Hardware7253/GP1247AI_PSU/3D/PCB_Assembly.step

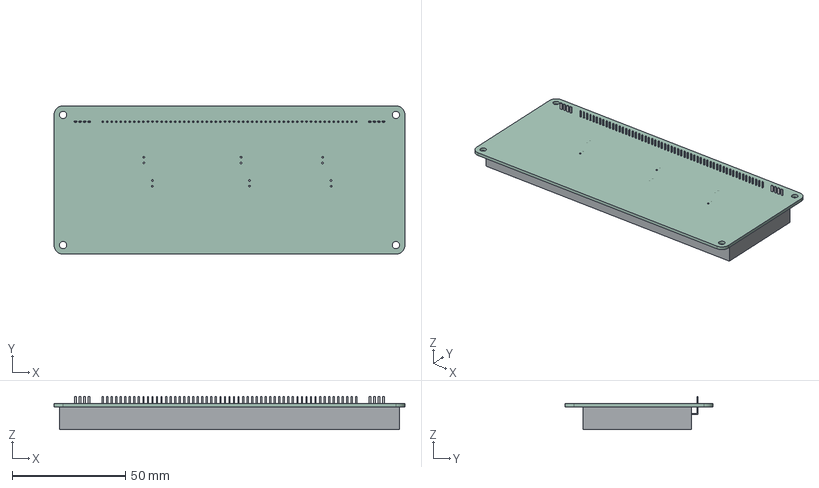
[picture p1: CAD file, 2026-01-06]
3D/PCB_Assembly.step
155.0 x 65.5 x 14.8 mm
Pin x 57
Filament Pin x 8
GP1247AI_PCB
