Hardware7253/GP1247AI_PSU/GP1247AI.kicad_sch

## KiCad design GP1247AI.kicad_sch (2026-01-14)

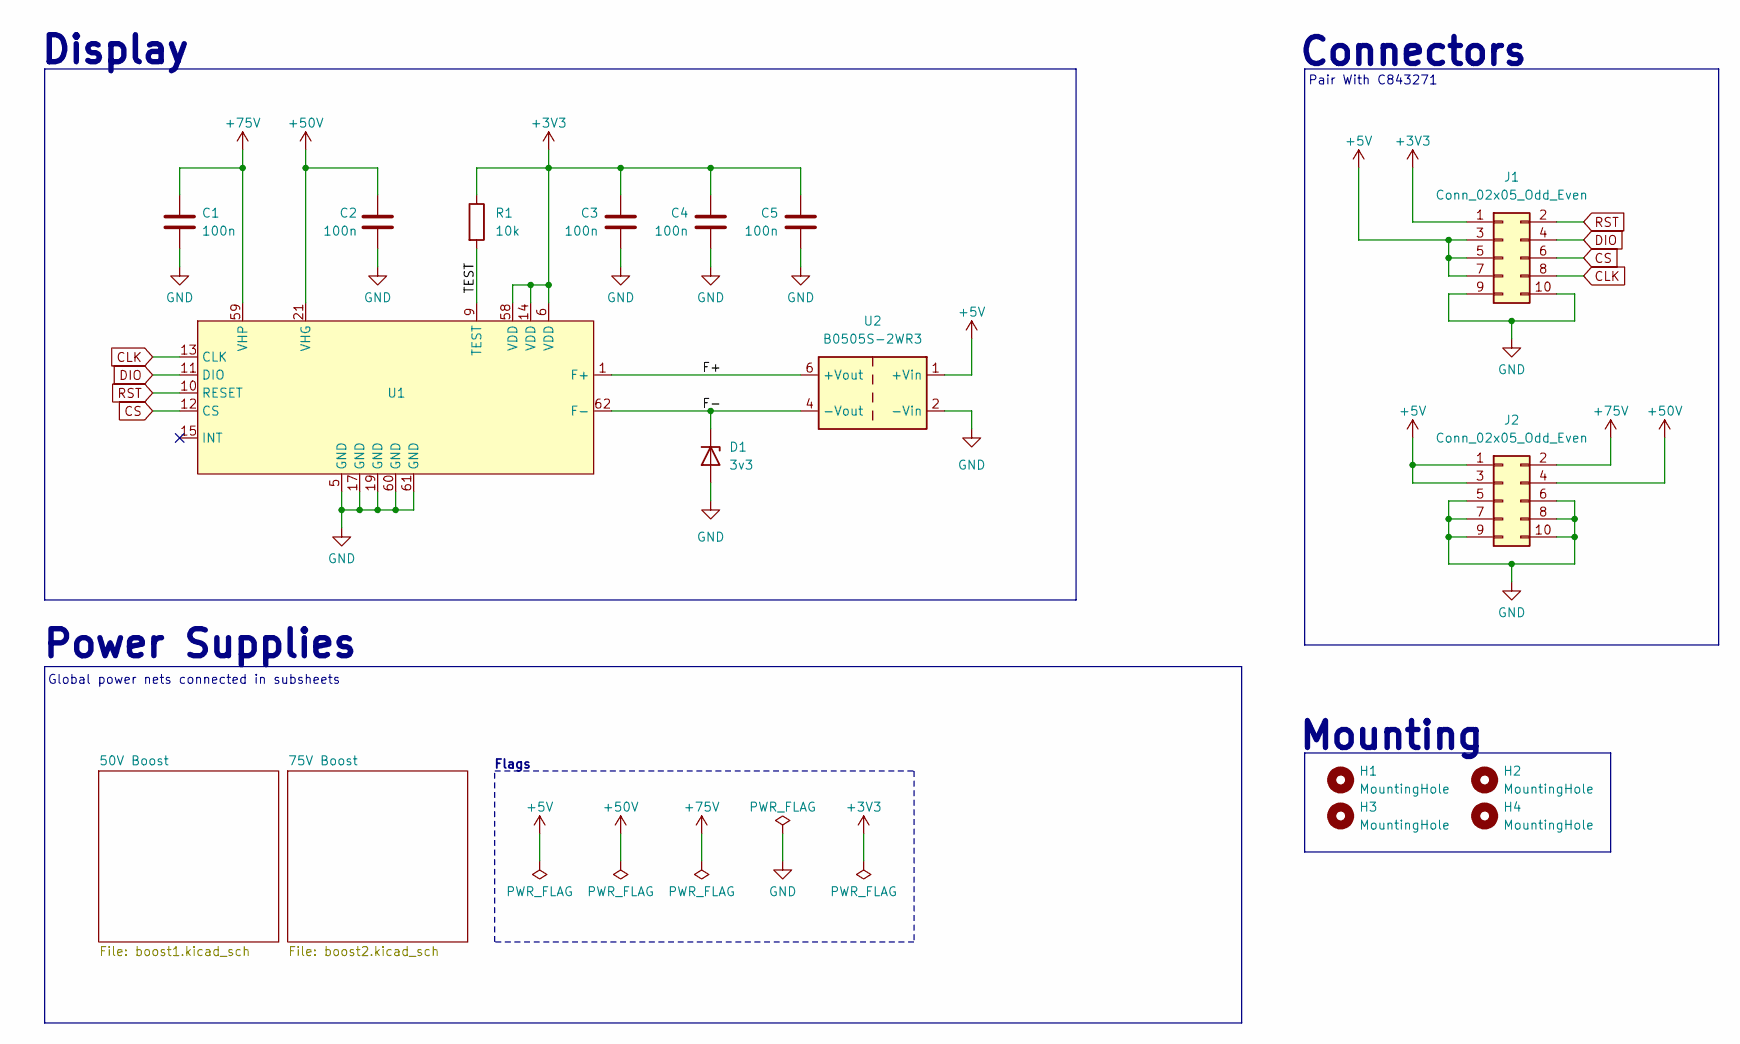
[picture p2: schematic GP1247AI.kicad_sch]

Parts:
C1, C2, C3, C4, C5: 100n; C_0603_1608Metric; LCSC PART # C15725
D1: 3v3; D_SOD-123; LCSC PART # C151564
H1, H2, H3, H4: MountingHole; MountingHole_3.2mm_M3
J1, J2: Conn_02x05_Odd_Even; PinHeader_2x05_P2.54mm_Vertical; LCSC PART # C42431818
R1: 10k; R_0603_1608Metric; LCSC PART # C49652949
U1: GP1247AI
U2: B0505S-2WR3; LCSC PART # C7465195

Connections:
+3V3: C3.1, C4.1, C5.1, J1.1, R1.1, U1.6 (VDD), U1.14 (VDD), U1.58 (VDD)
+5V: J1.3, J1.5, J1.7, J2.1, J2.3, U2.1 (+Vin)
+50V: C2.1, J2.4, U1.21 (VHG)
+75V: C1.1, J2.2, U1.59 (VHP)
CLK: J1.8, U1.13 (CLK)
CS: J1.6, U1.12 (CS)
DIO: J1.4, U1.11 (DIO)
F+: U1.1 (F+), U1.2 (F+), U1.3 (F+), U1.4 (F+), U2.6 (+Vout)
F-: D1.1 (K), U1.62 (F-), U1.63 (F-), U1.64 (F-), U1.65 (F-), U2.4 (-Vout)
GND: C1.2, C2.2, C3.2, C4.2, C5.2, D1.2 (A), J1.9, J1.10, J2.5, J2.6, J2.7, J2.8, J2.9, J2.10, U1.5 (GND), U1.17 (GND), U1.19 (GND), U1.60 (GND), U1.61 (GND), U2.2 (-Vin)
RST: J1.2, U1.10 (RESET)
TEST: R1.2, U1.9 (TEST)

Notes on the sheet:
Mounting
Display
Pair With C843271
Global power nets connected in subsheets
Power Supplies
Connectors
Flags
