Hardware7253/GP1247AI_PSU/boost2.kicad_sch

## KiCad design boost2.kicad_sch (2026-01-14)

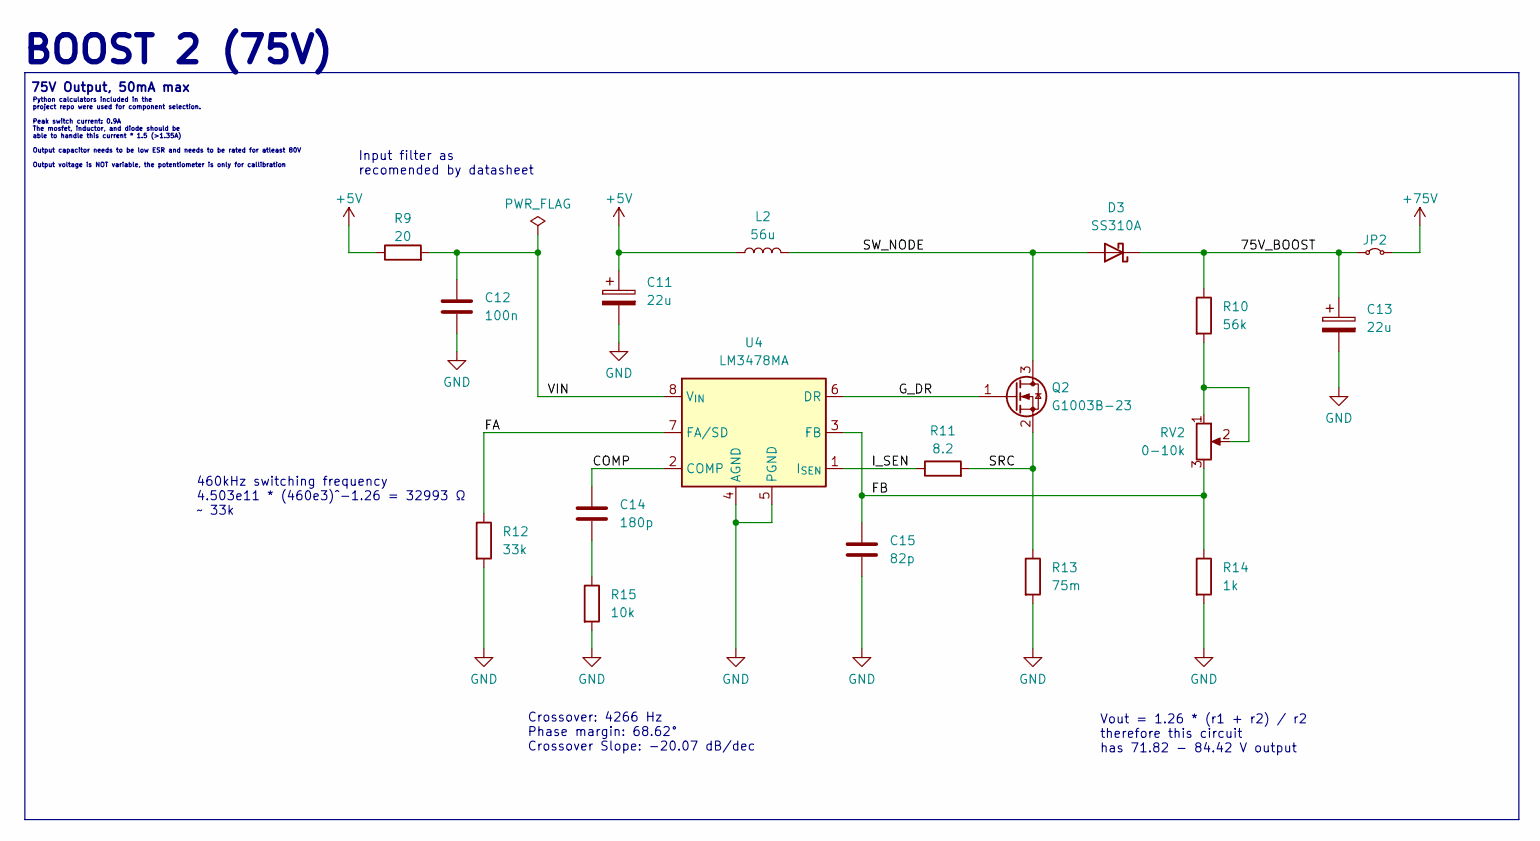
[picture p4: schematic boost2.kicad_sch]

Parts:
C11, C13: 22u; CP_Radial_D6.3mm_P2.50mm; LCSC PART # C44606504
C12: 100n; C_0603_1608Metric; LCSC PART # C15725
C14: 180p; C_0603_1608Metric; LCSC PART # C2170987
C15: 82p; C_0603_1608Metric; LCSC PART # C1864236
D3: SS310A; D_SMA; LCSC PART # C48996628
JP2: Jumper_2_Small_Bridged; PinHeader_1x02_P2.54mm_Vertical; LCSC PART # C41432920
L2: 56u; Chilisin SCDS105R; LCSC PART # C329728
Q2: G1003B-23; SOT-23-3; LCSC PART # C22362809
R9: 20; R_0603_1608Metric; LCSC PART # C2907012
R10: 56k; R_0603_1608Metric; LCSC PART # C2907053
R11: 8.2; R_0603_1608Metric; LCSC PART # C861594
R12: 33k; R_0603_1608Metric; LCSC PART # C2907028
R13: 75m; R_1206_3216Metric; LCSC PART # C2904225
R14: 1k; R_0603_1608Metric; LCSC PART # C2907002
R15: 10k; R_0603_1608Metric; LCSC PART # C49652949
RV2: 0-10k; Potentiometer_Bourns_TC33X_Vertical; LCSC PART # C719176
U4: LM3478MA; SOIC-8_3.9x4.9mm_P1.27mm; LCSC PART # C115907

Connections:
75V_BOOST: C13.1, D3.1 (K), JP2.1 (A), R10.1
+5V: C11.1, L2.1, R9.1
+75V: JP2.2 (B)
COMP: C14.1, U4.2 (COMP)
FA: R12.1, U4.7 (FA/SD)
FB: C15.1, R14.1, RV2.3, U4.3 (FB)
GND: C11.2, C12.2, C13.2, C15.2, R12.2, R13.2, R14.2, R15.2, U4.4 (AGND), U4.5 (PGND)
G_DR: Q2.1 (G), U4.6 (DR)
I_SEN: R11.1, U4.1 (I_{SEN})
unnamed: C14.2, R15.1
unnamed: R10.2, RV2.1, RV2.2
SRC: Q2.2 (S), R11.2, R13.1
SW_NODE: D3.2 (A), L2.2, Q2.3 (D)
VIN: C12.1, R9.2, U4.8 (V_{IN})

Notes on the sheet:
75V Output, 50mA max
460kHz switching frequency 4.503e11 * (460e3)^-1.26 = 32993 Ω ~ 33k
BOOST 2 (75V)
Python calculators included in the project repo were used for component selection. Peak switch current: 0.9A The mosfet, inductor, and diode should be able to handle this current * 1.5 (>1.35A) Output capacitor needs to be low ESR and needs to be rated for atleast 80V Output voltage is NOT variable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
Input filter as recomended by datasheet
Vout = 1.26 * (r1 + r2) / r2 therefore this circuit has 71.82 - 84.42 V output
Crossover: 4266 Hz Phase margin: 68.62° Crossover Slope: -20.07 dB/dec
