Hardware7253/GP1247AI_PSU/(commit log)

2026-01-06 Removed 8V boost converter
    Now using an isolated 5V power supply module
    [GP1247AI.kicad_sch, GP1247AI_BOM.csv, PCB_Assembly.step, TestPoint_Keystone_5019_Minature.step, boost1.kicad_sch, boost2.kicad_sch, boost3.kicad_sch]
2026-01-14 Fixed boost2 feedback resistors
    Old feedback resistor network made output voltage too high
    [GP1247AI.kicad_sch, GP1247AI_BOM.csv, boost1.kicad_sch, boost2.kicad_sch]
